Indius23/Projecting-and-making-a-preamplier-with-gain-control-using-Cadence-tools-/Gabriel_Sava_432B.pdf

Universitatea Națională de Știință și Tehnologie POLITEHNICA București Facultatea E.T.T.I.
Anul universitar 2024-2025

## Proiectarea și realizarea unui

## preamplificator audio cu amplificarea

## controlată de tensiune

N = 2

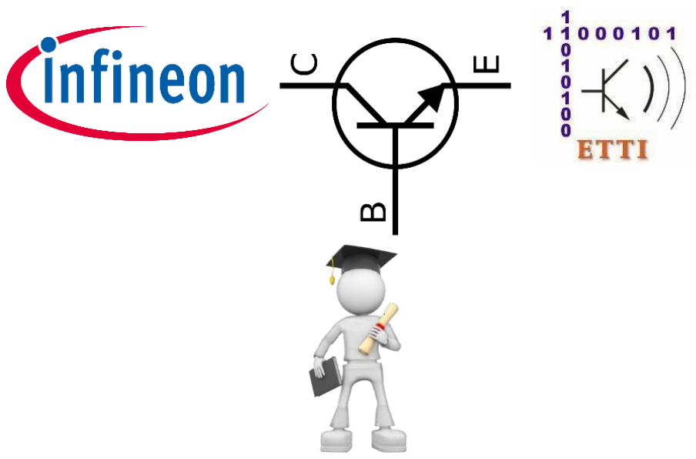
[picture p1: figure]

Coordonatori științifici | Sava Gabriel
Prof. dr. ing. Dragoș Dobrescu | grupa 432B

Ș.l. dr. ing. Mădălin Moise

## Cuprins

- 3.6.Puncte statice de funcționare – PSF | 11-14
•
IV.Proiectarea și realizarea circuitului în tehnologie SMT &
- 4.3.Imaginea măștii de inscripționare (layer-ul neelectric SSTOP).......17

## I. Introducere

Amplificatoarele cu amplificarea controlată în tensiune (Voltage Controlled Amplifiers - VCA) reprezintă o categorie importantă de dispozitive utilizate pe scară largă în aplicații audio, telecomunicații și sisteme de procesare a semnalelor. Aceste amplificatoare oferă un avantaj semnificativ prin capacitatea lor de a ajusta câștigul (nivelul de amplificare) în timp real, în funcție de o tensiune de control aplicată. Această caracteristică le face indispensabile în scenarii care necesită adaptabilitate ridicată și o precizie deosebită.
Funcționalitatea unui VCA se bazează pe un principiu simplu: tensiunea de control modifică parametrii interni ai circuitului, ceea ce permite reglarea continuă și dinamică a amplificării. Această versatilitate este esențială în aplicații precum mixere audio, procesoare de dinamică (compresoare, limitatoare), egalizatoare parametrice sau chiar circuite de corecție automată a semnalelor.
Avantajele amplificatoarelor cu amplificare controlată în tensiune includ răspunsul rapid la variații, reducerea intervenției mecanice (cum ar fi ajustarea manuală a câștigului) și integrarea lor ușoară în sisteme automate. În plus, aceste amplificatoare contribuie la îmbunătățirea raportului semnal-zgomot (SNR) și reduc la minimum distorsiunile în procesarea semnalului.
Dezvoltarea și utilizarea amplificatoarelor cu amplificarea controlată în tensiune continuă să evolueze, fiind un domeniu de interes pentru proiectarea de sisteme audio și electronice de înaltă performanță. Aceste dispozitive oferă nu doar flexibilitate în controlul semnalului, ci și un nivel ridicat de integrare și adaptabilitate, necesar într-o lume din ce în ce mai orientată spre tehnologii inteligente și optimizate.

## II. Date inițiale de proiectare

### 2.1. Descrierea temei

Să se proiecteze şi să se realizeze practic un preamplificator de audiofrecvență cu control în tensiune având următoarele caracteristici:

- Tensiunea de alimentare bipolară (VCC=12V, VEE=-VCC). Semnalizarea prezenței tensiunii cu LED.
- Tensiune de intrare sinusoidală cu amplitudinea cuprinsă între 0 și 20 mV.
- Frecvența semnalului de intrare de 2 kHz.
- Tensiunea continuă de control a amplificării cuprinsă între 0 și 2 V.
- Amplificarea în tensiune controlată cuprinsă între 1 și 20.
- Rezistența de sarcină 700 Ω.

### 2.2. Schema bloc a montajului electric

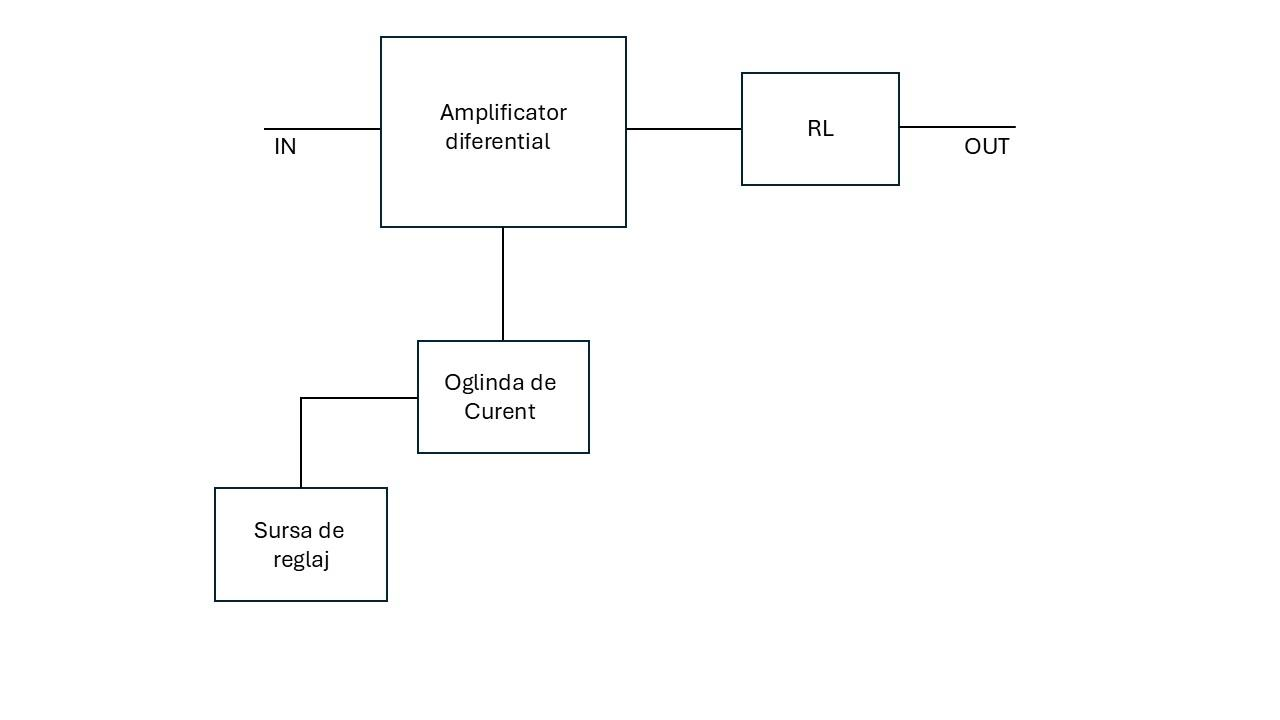
[picture p2: figure]

## III.Conținutul tehnic al proiectului

### 3.1. Schema electrică a montajului electric

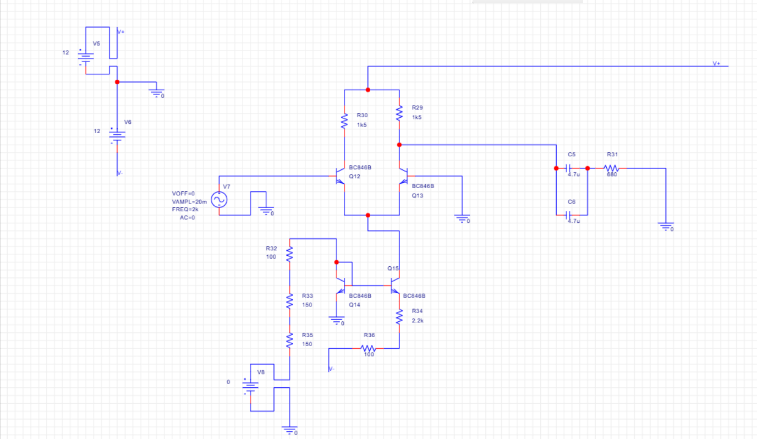
[picture p3: figure]

### 3.2. Simularea preamplificatorului cu tensiunea de reglaj de 0V

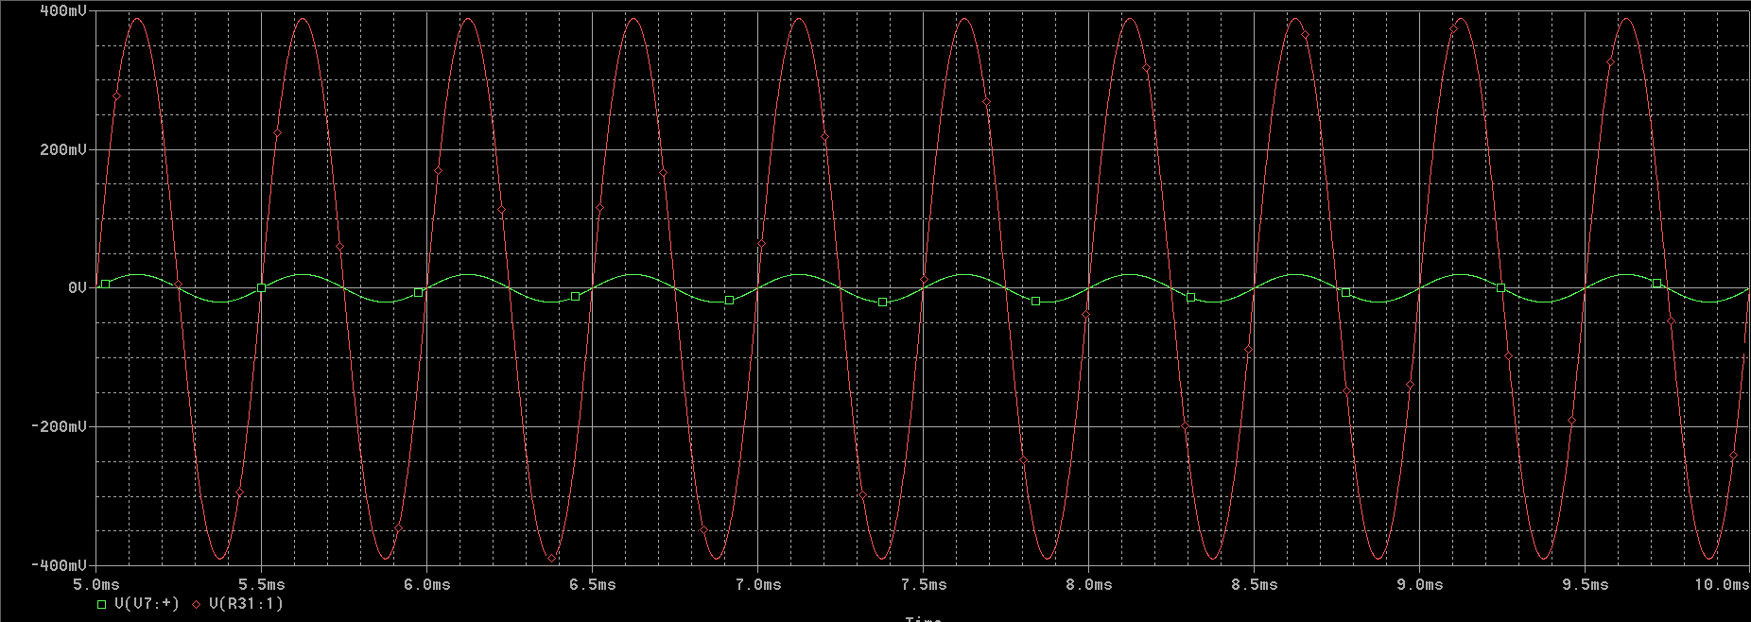
[picture p4: figure]

### 3.3. Simularea preamplificatorului cu tensiunea de reglaj de 1V

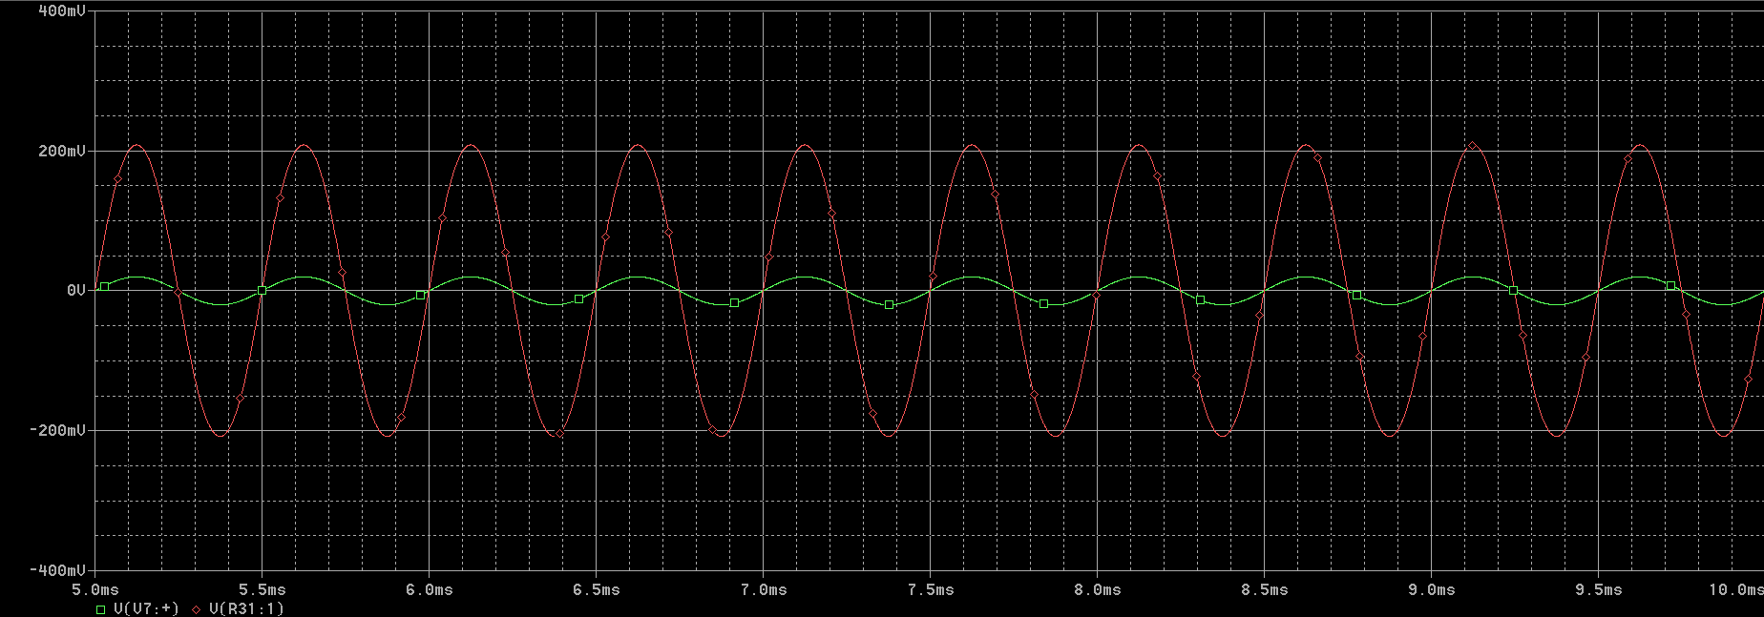
[picture p5: figure]

### 3.4. Simularea preamplificatorului cu tensiunea de reglaj de 2V

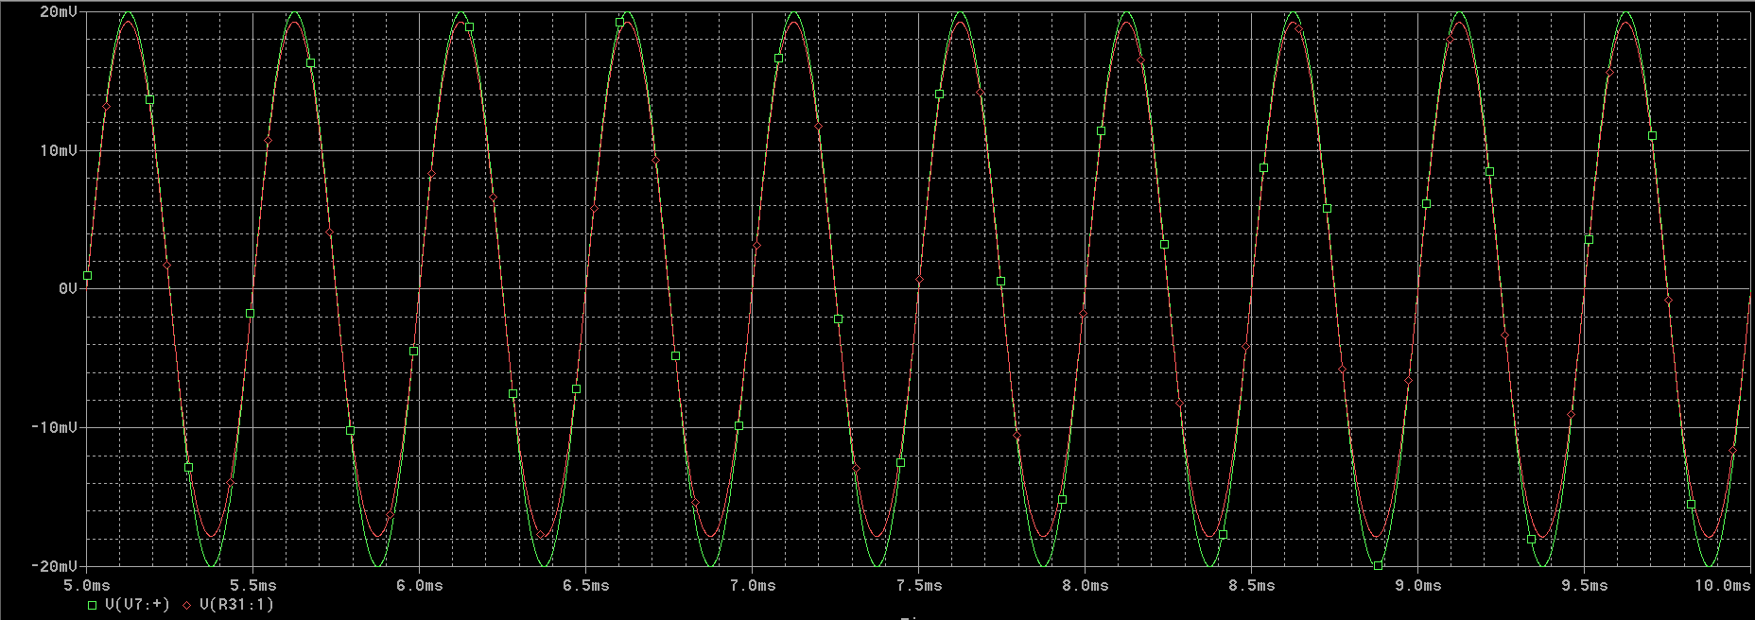
[picture p6: figure]

### 3.5. Bill of materials(BOM)

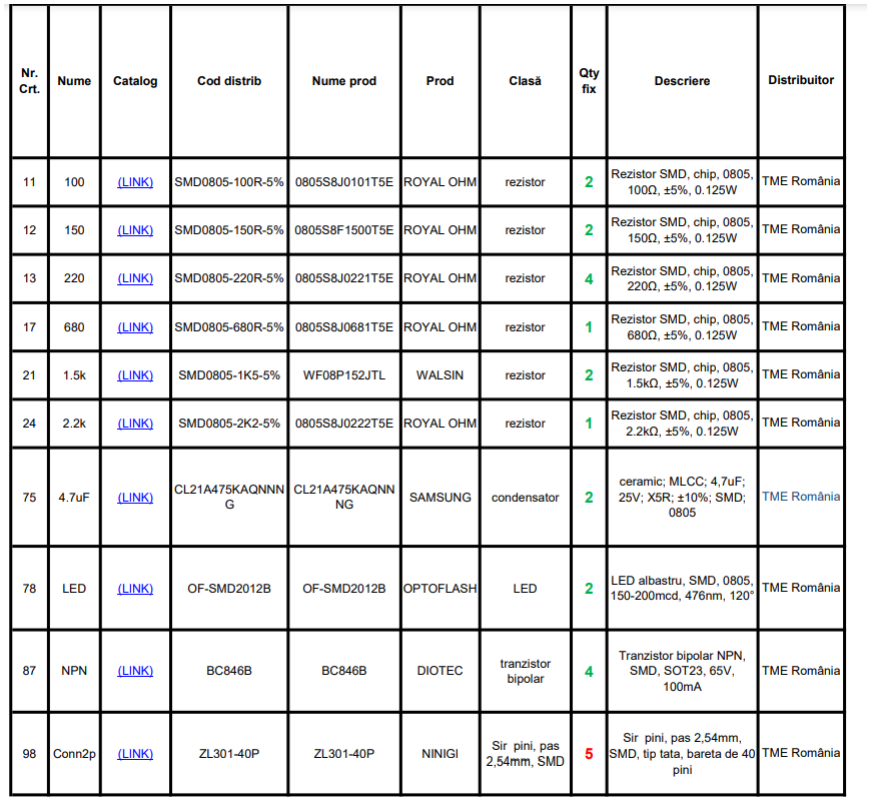
[picture p7: figure]

### 3.6. Puncte statice de funcționare – PSF

### - Curenți

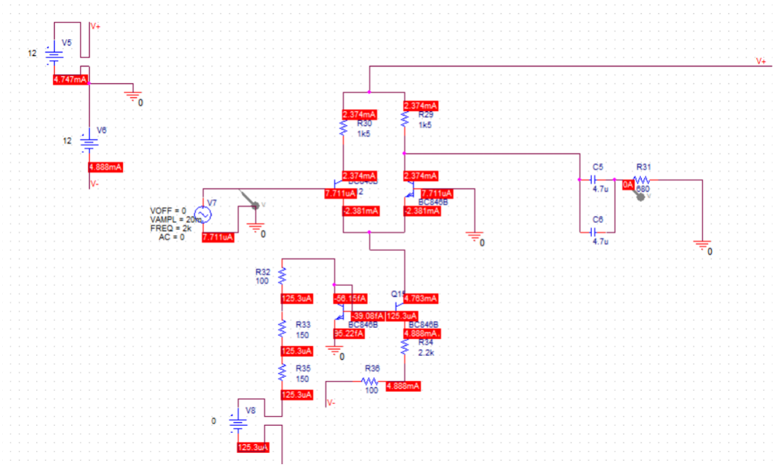
[picture p8: figure]

### - Tensiuni

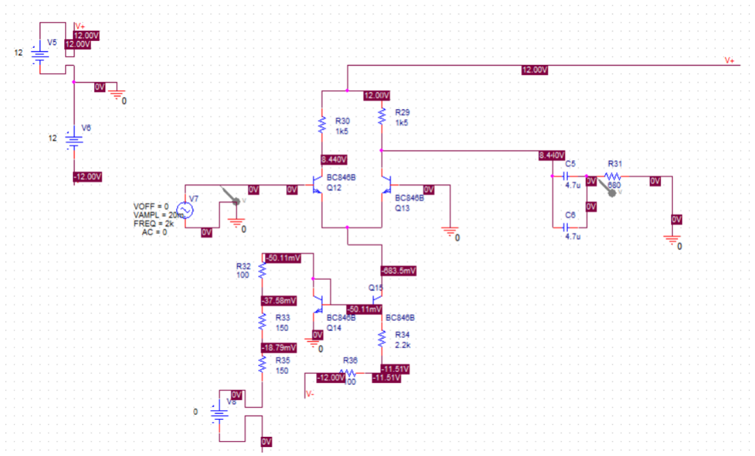
[picture p9: figure]

### - Puteri

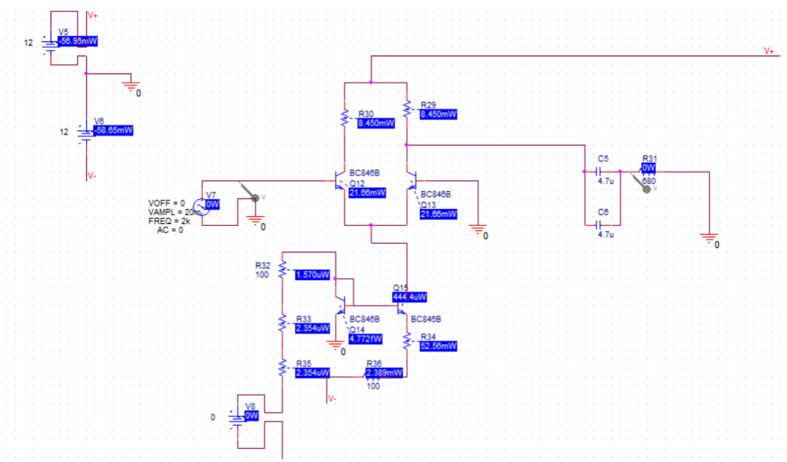
[picture p10: figure]
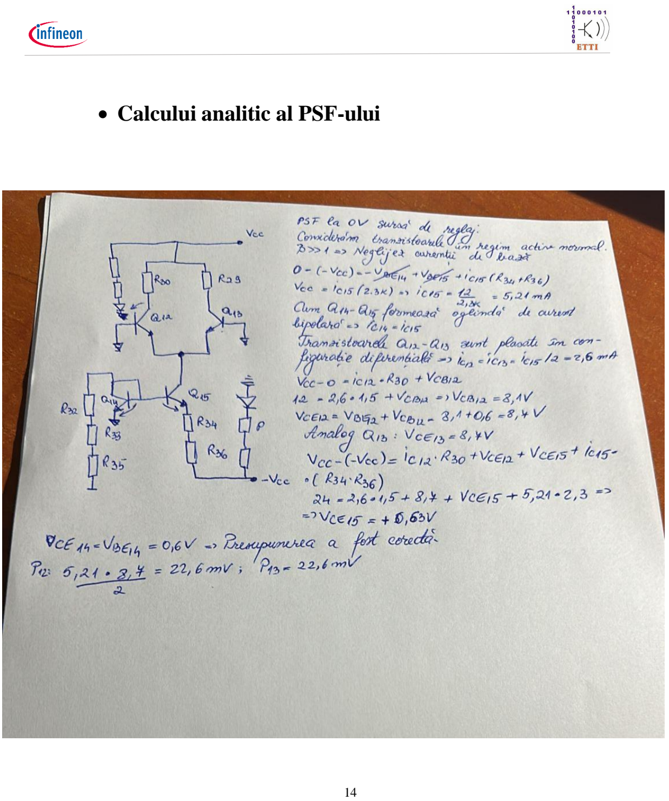
[picture p11: page 14]

### - Calcului analitic al PSF-ului

## IV.Proiectarea și realizarea circuitului în tehnologie SMT & PCB

### 4.1. Imaginea structurii de interconectare (layer-ul electric TOP)

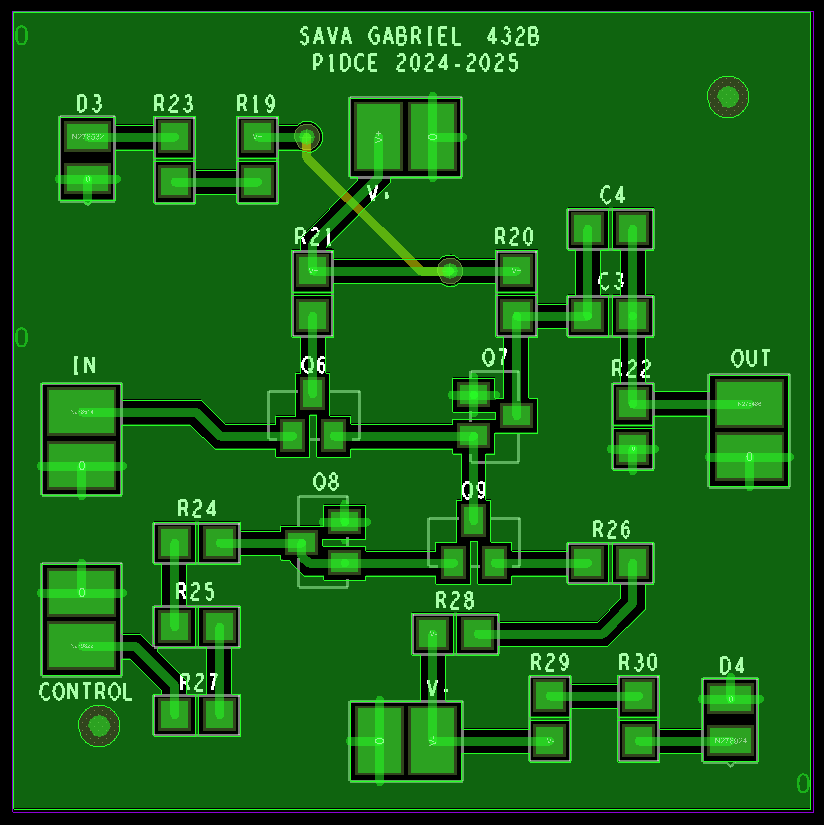
[picture p12: figure]

### 4.2. Imaginea de interconectare (layer-ul electric BOTTOM)

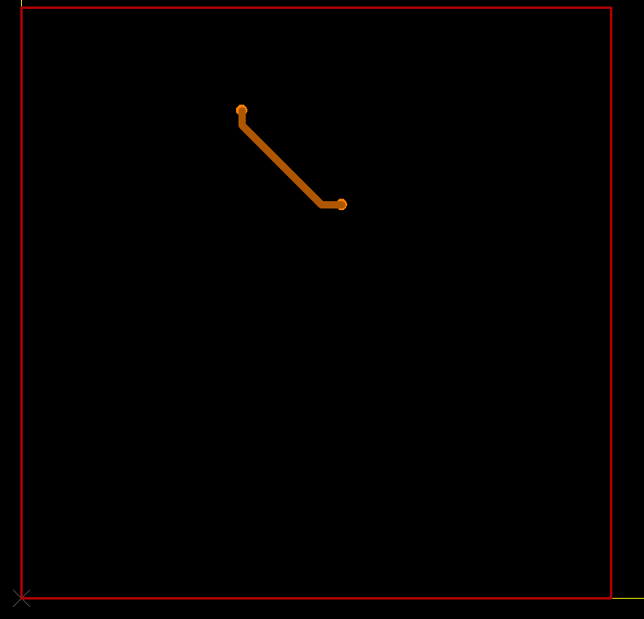
[picture p13: figure]

### 4.3. Imaginea măștii de inscripționare (layer-ul neelectric SSTOP)

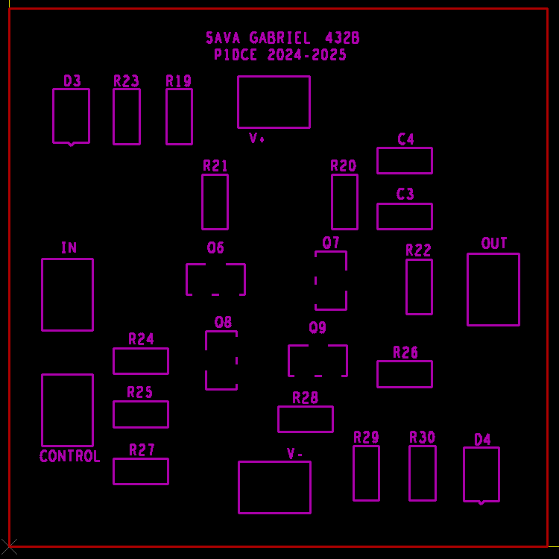
[picture p14: figure]

### 4.4. Imaginea măștii de protecție (layer-ul neelectric SMTOP)

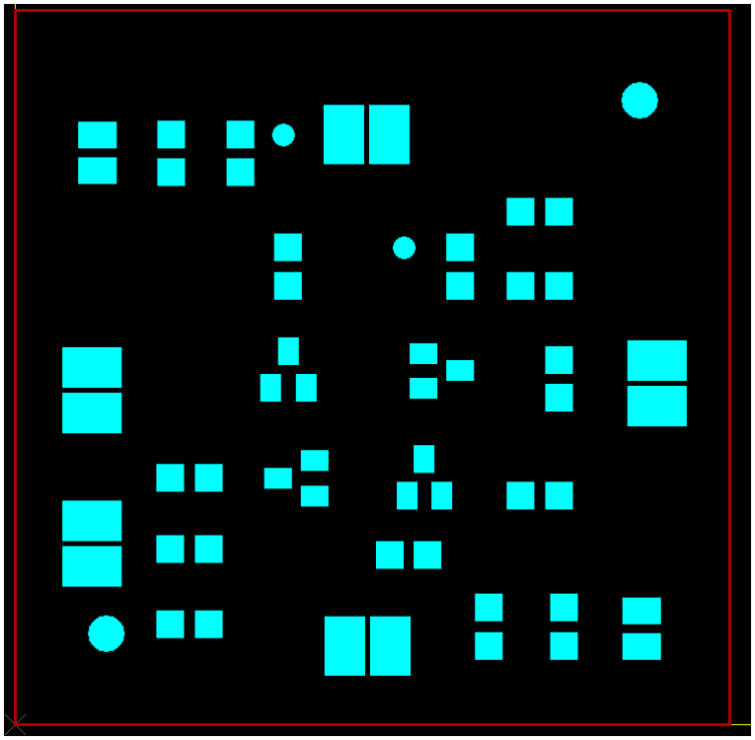
[picture p15: figure]

### 4.5. Imaginea șablonului (layer-ul neelectric SPTOP)

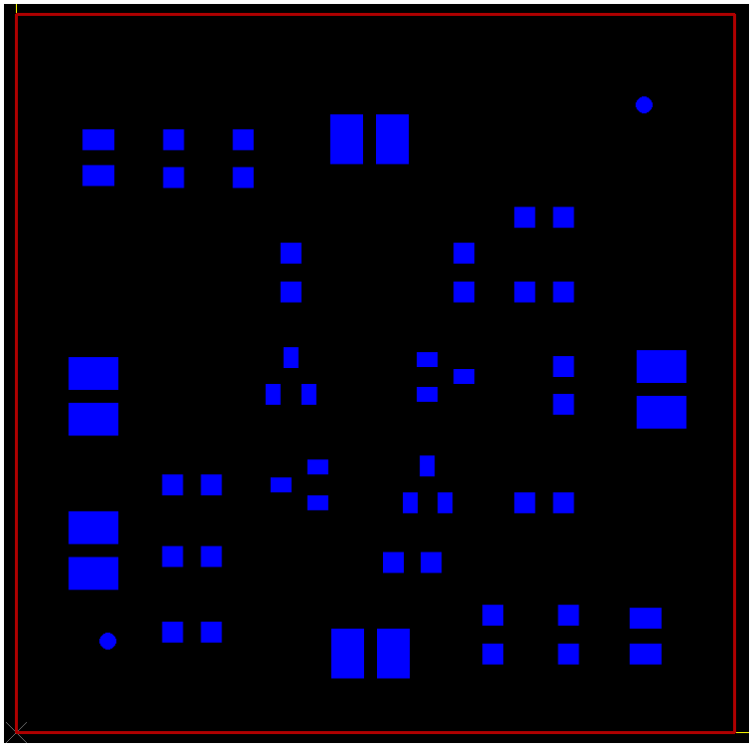
[picture p16: figure]

### 4.6. Imaginea layer-ului neelectric mecanic (FAB)

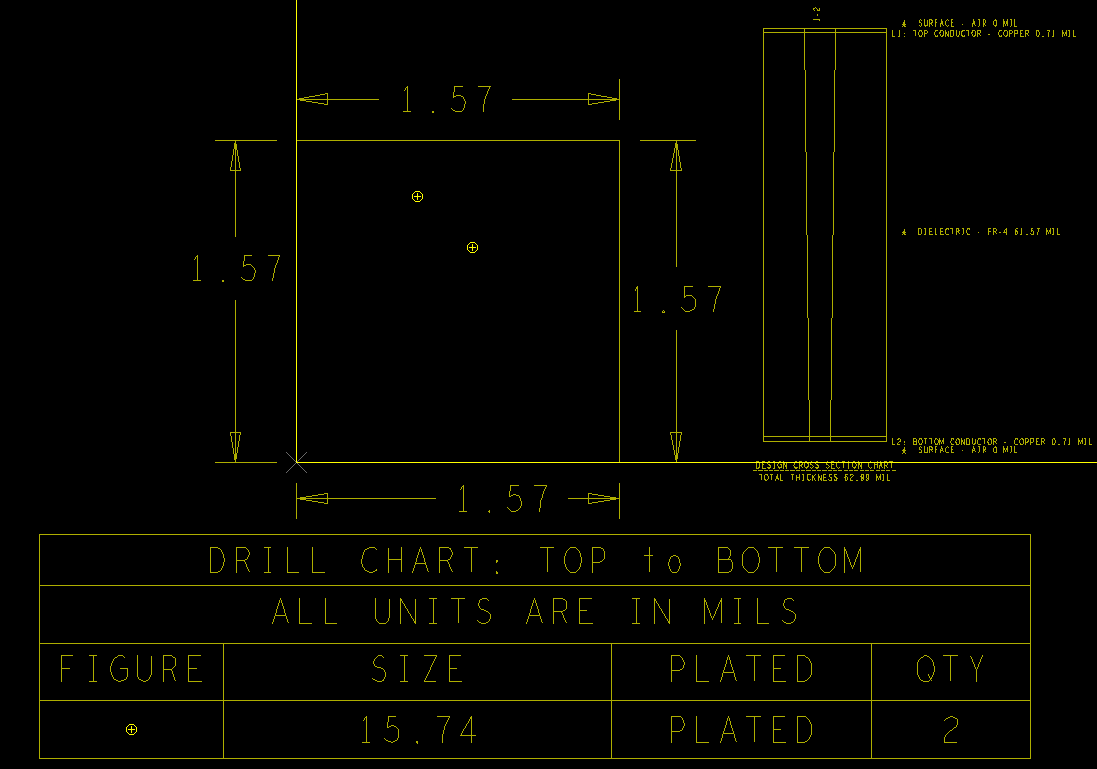
[picture p17: figure]

### 4.7. Mod de realizare

Unelte necesare

Lipirea componentelor constă în fixarea și stabilirea unui contact electric între terminalele acestora, utilizând un aliaj de tip SnAgCu. Pentru acest proces sunt necesare câteva unelte esențiale: stația de lipit, cositorul (aliajul de lipire) și fluxul. Unele aliaje de lipire sunt disponibile sub formă de fire cu unul sau mai multe nuclee de flux integrate, care traversează centrul firului de lipire. Acest flux incorporat facilitează procesul de lipire, însă poate fi nedorit în anumite situații, cum ar fi necesitatea curățării post-lipire.
Fluxul este un agent chimic esențial în procesul de lipire, având rolul principal de pregătire a suprafețelor de lipire. Acesta elimină oxizii și impuritățile, asigurând o lipire de calitate. Pentru corectarea lipiturilor greșite sau îndepărtarea cositorului în exces, se poate utiliza tresa absorbantă.

Procedura de lipire
1. Setarea temperaturii
Reglez temperatura vârfului de lipit la aproximativ 370°C, adecvată pentru componentele utilizate în acest proiect. La finalul procesului de lipire, nu curăț vârful de lipit de cositor pentru a preveni oxidarea acestuia în perioada de inactivitate.
2. Utilizarea tresei absorbante
- Plasez tresa absorbantă între zona de cupru ce necesită curățare și ciocanul de lipit.
- Când temperatura ajunge la punctul de topire al aliajului, acesta va fi transferat de pe PCB către tresă, până când aceasta se saturează.
- Atenție: Evit mișcarea orizontală a tresei pe suprafața PCB-ului, deoarece acest lucru poate duce la desprinderea pad-urilor componentelor de pe substrat. Utilizez tresa doar perpendicular pe zonele ce urmează a fi curățate.

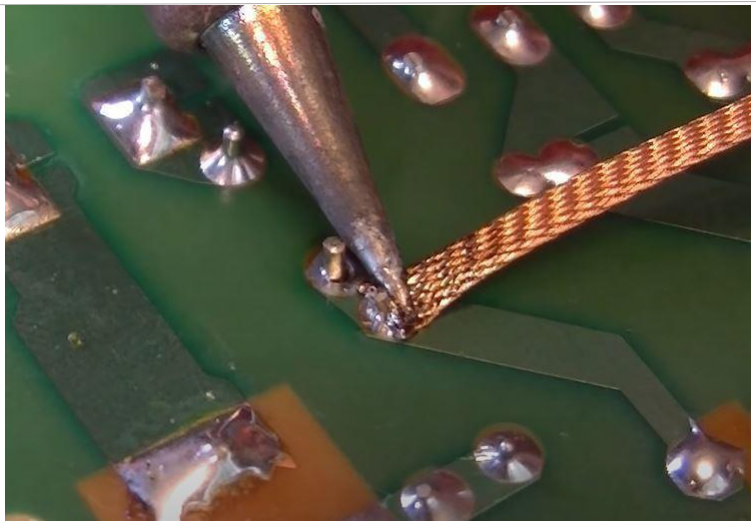
[picture p18: figure]

## V. Manual de utilizare

Preamplificatorul audio cu amplificare controlată în tensiune a fost proiectat pentru a funcționa în regim optim la tensiunea de alimentare bipolară de 12V și tensiune de intrare sinusoidală cu valori cuprinse între 0 și 20mV.
- Se conecteaza toate bornele “-“ la GND;
- Se alimentează circuitul la 12V;
- Tensiunea de intrare se conectează la borna IN a circuitului;
- Se variază amplificarea dintr-o altă sursă, cu valori intre 0V si 2V, la 0V avem amplificare maxima, iar la 2V semnalul de intrare este repetat;
- A nu se atinge sau modifica elementele componente/conexiunile în timpul funcționării
- A se manevra cu grijă plăcuța, ținându-se de marginile acesteia;
- A se feri de umezeală, îngheț, expunerea îndelungată la razele soarelui;
- Temperatură ambientală recomandată: 25 °C;
- A nu se lăsa la îndemâna copiilor;

## VI. Bibliografie

- https://hobbytronica.ro/amplificator-audio-cu-un-tranzistor-bipolar/ (https://hobbytronica.ro/amplificator-audio-cu-un-tranzistor-bipolar/)
- G. Brezeanu, F. Drăghici, Circuite electronice fundamentale, Ed. Niculescu, Bucureşti, 2013;
- G. Brezeanu, F. Draghici, F. Mitu, G. Dilimot, Circuite electronice fundamentale - probleme, Editura Rosetti Educational, Bucuresti, editia II–2008;
- Note de curs - Circuite electronice fundamentale, Dragoș Dobrescu
- Platforme Laborator Tehnici CAD de Realizare a Modulelor Electronice, Norocel Codreanu
- Platforme Laborator Tehnici de Interconectare în Electronică, Norocel Codreanu
- http://www.dce.pub.ro;
- http://www.cetti.ro/v2/tehnicicad.php;
- Designing a classic transistor-VCA from scratch -https://www.youtube.com/watch?v=yMrCCx6uqcE
