Indius23/Projecting-and-making-a-preamplier-with-gain-control-using-Cadence-tools-/P1/2.gerbere_ss/SMTOP.png

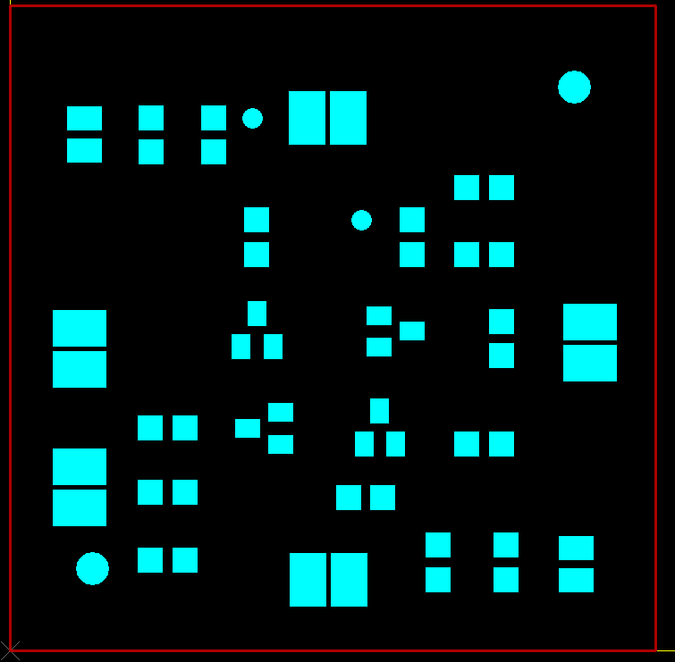
P1/2.gerbere_ss/SMTOP.png
