Indius23/Projecting-and-making-a-preamplier-with-gain-control-using-Cadence-tools-/(list of files, drawings)

Other design files:
P1/layout.opj
P1/P1_V2.DSN
